DangyDang/LISN/README.md

## Project Status & Updates

Hi everyone!

I'm still working on this project, so the documentation is not complete yet. There are still two chapters planned for future updates:

- **Board Evaluation**
- **Measurement Implementation**

If you have any suggestions, feedback, or questions, feel free to open an issue or leave a comment. I'd really appreciate your input. Thanks for your interest in this project!

### Update — November 7, 2026

I've made quite a few changes to the documentation.

Most notably, I completely reworked the simulation section. During the debugging process, I found that a different simulation approach made the circuit behavior and measurement principles much easier to understand, so I decided to rewrite that part from scratch.

There is still one chapter left to complete: - **Measurement Implementation**. I'll cover the practical setup and measurement procedure in that chapter.

The project is still a work in progress, but I'm getting closer to a complete documentation set.

Stay tuned, and thanks for following along!

### Update — November 9, 2026

The project is officially complete!

I've finished the documentation.

This project has been a great hands-on learning experience, covering circuit design, simulation, PCB development, debugging, and EMC measurements.

Thank you to everyone who has shown interest in this project. Feedback and suggestions are still welcome!

**Project Status: Completed.**

P.S. Special thanks to Nguyen Thanh Long and Nguyen Thanh Tung from the Sensor Lab, SEEE-HUST, for their help and support throughout this project!
