DangyDang/LISN/LISN verifi.asc

C1: cap; 10µ
C2: cap; 100n
C_par: cap; 1p
L1: ind; 5µ; Rser=1m
R1: res; 0.1
R2: res; 50
R3: res; 0.001
R: res; 1k
V1: voltage; ""; AC 1
V2: voltage; 5
Named nets: 0, Noise_from_DUT, RF_OUT, Power_in
.ac dec 1000 10k 150MEG
POWER SOURCE
DUT
